enkhbold470/ice-core/media/bottom.png

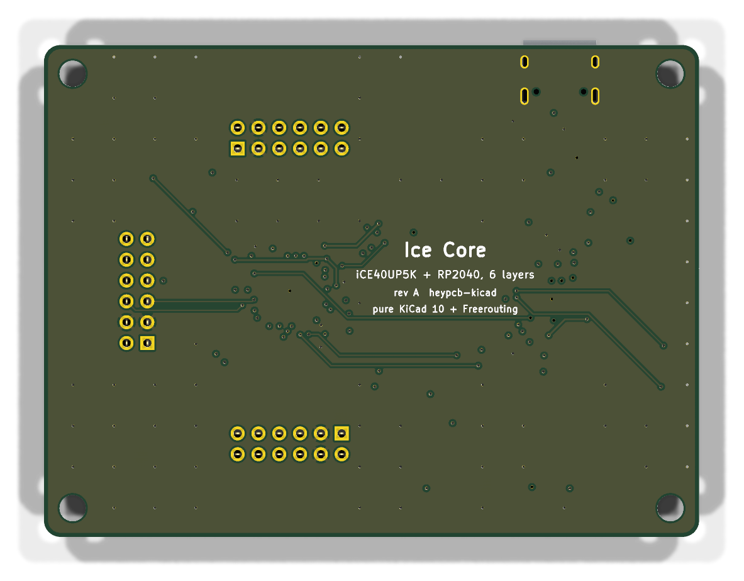
media/bottom.png
