enkhbold470/ice-core/media/top.png

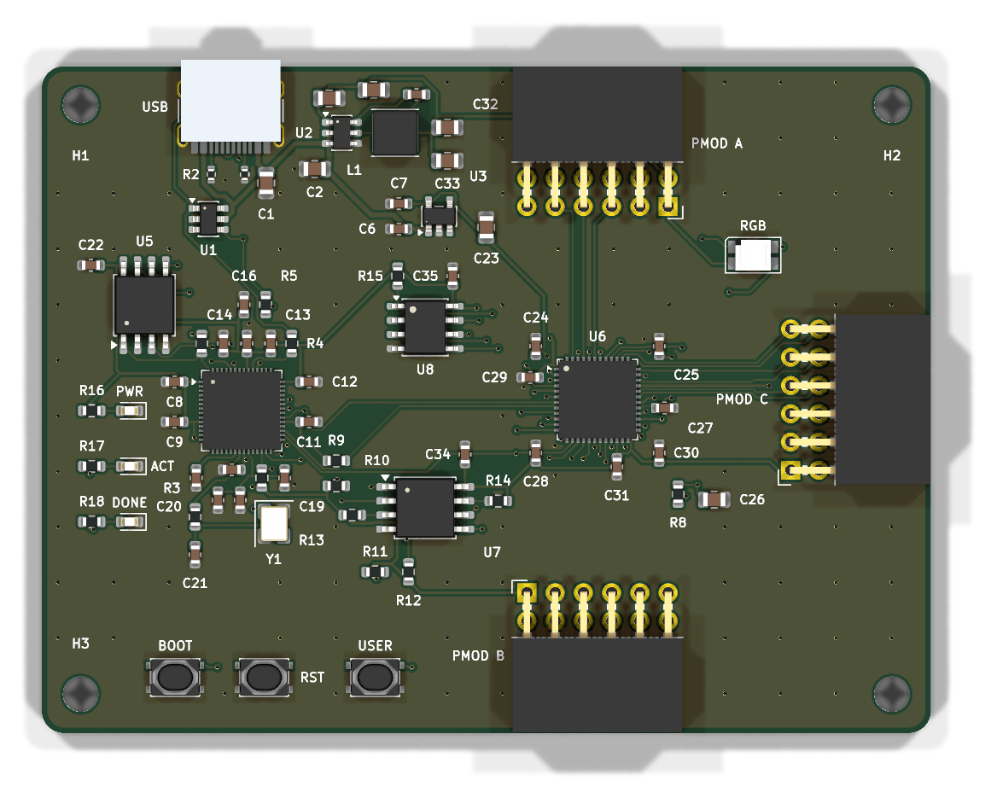
media/top.png
