enkhbold470/ice-core/fab/ice_core_bom.csv

Reference | Value | Footprint | MPN | LCSC | Qty
C1,C2 | 10uF | Capacitor_SMD:C_0805_2012Metric | CL21A106KAYNNNE | C15850 | 2
C3,C4 | 22uF | Capacitor_SMD:C_0805_2012Metric | CL21A226MAQNNNE | C45783 | 2
C5,C8,C9,C10,C11,C12,C13,C14,C15,C18,C19,C22,C24,C25,C27,C28,C29,C30,C31,C34,C35 | 100nF | Capacitor_SMD:C_0603_1608Metric | CC0603KRX7R9BB104 | C14663 | 21
C6,C7,C16,C17 | 1uF | Capacitor_SMD:C_0603_1608Metric | CL10A105KB8NNNC | C15849 | 4
C20,C21 | 15pF | Capacitor_SMD:C_0603_1608Metric | CL10C150JB8NNNC | C1644 | 2
C23,C26,C32,C33 | 4.7uF | Capacitor_SMD:C_0805_2012Metric | CL21A475KAQNNNE | C1779 | 4
D1 | RGB | LED_SMD:LED_Avago_PLCC4_3.2x2.8mm_CW | S4-3528RGBTA-A | C2827321 | 1
D2 | Green (PWR) | LED_SMD:LED_0603_1608Metric | KT-0603G | C12624 | 1
D3 | Red (ACT) | LED_SMD:LED_0603_1608Metric | KT-0603R | C2286 | 1
D4 | Orange (DONE) | LED_SMD:LED_0603_1608Metric | XL-1608UOC-06 | C965800 | 1
J1 | USB-C | Connector_USB:USB_C_Receptacle_HRO_TYPE-C-31-M-12 | TYPE-C-31-M-12 | C165948 | 1
J2 | PMOD_A | Connector_PinSocket_2.54mm:PinSocket_2x06_P2.54mm_Horizontal | PM254-2-06-W-8.5 | C2897426 | 1
J3 | PMOD_B | Connector_PinSocket_2.54mm:PinSocket_2x06_P2.54mm_Horizontal | PM254-2-06-W-8.5 | C2897426 | 1
J4 | PMOD_C | Connector_PinSocket_2.54mm:PinSocket_2x06_P2.54mm_Horizontal | PM254-2-06-W-8.5 | C2897426 | 1
L1 | 3.9uH | Inductor_SMD:L_Sunlord_SWPA4030S | SWPA4030S3R9MT | C96899 | 1
R1,R2 | 5.1k | Resistor_SMD:R_0402_1005Metric | 0402WGF5101TCE | C25905 | 2
R3,R6,R17,R18 | 1k | Resistor_SMD:R_0603_1608Metric | 0603WAF1001T5E | C21190 | 4
R4,R5 | 27 | Resistor_SMD:R_0603_1608Metric | 0603WAF270JT5E | C25190 | 2
R7,R9,R10,R11,R12,R13,R14,R15 | 10k | Resistor_SMD:R_0603_1608Metric | FRC0603F1002TS | C2906982 | 8
R8 | 100 | Resistor_SMD:R_0603_1608Metric | 0603WAF1000T5E | C22775 | 1
R16 | 2.2k | Resistor_SMD:R_0603_1608Metric | 0603WAF2201T5E | C4190 | 1
SW1 | BOOT | Button_Switch_SMD:SW_SPST_PTS810 | PTS810SJM250SMTRLFS | C116501 | 1
SW2 | RESET | Button_Switch_SMD:SW_SPST_PTS810 | PTS810SJM250SMTRLFS | C116501 | 1
SW3 | USER | Button_Switch_SMD:SW_SPST_PTS810 | PTS810SJM250SMTRLFS | C116501 | 1
U1 | USBLC6-2SC6 | Package_TO_SOT_SMD:SOT-23-6 | USBLC6-2SC6 | C7519 | 1
U2 | AP63203WU | Package_TO_SOT_SMD:TSOT-23-6 | AP63203WU-7 | C780769 | 1
U3 | AP2112K-1.2 | Package_TO_SOT_SMD:SOT-23-5 | AP2112K-1.2TRG1 | C460310 | 1
U4 | RP2040 | Package_DFN_QFN:QFN-56-1EP_7x7mm_P0.4mm_EP3.2x3.2mm | RP2040 | C2040 | 1
U5,U7 | W25Q32JVSSIQ | Package_SO:SOIC-8_5.3x5.3mm_P1.27mm | W25Q32JVSSIQ | C179173 | 2
U6 | iCE40UP5K-SG48 | Package_DFN_QFN:QFN-48-1EP_7x7mm_P0.5mm_EP5.6x5.6mm | ICE40UP5K-SG48I | C2678152 | 1
U8 | APS6404L-3SQR-SN | Package_SO:SOIC-8_3.9x4.9mm_P1.27mm | APS6404L-3SQR-SN | C5333729 | 1
Y1 | 12MHz | Crystal:Crystal_SMD_3225-4Pin_3.2x2.5mm | ABM8-272-T3 | C20625731 | 1
