enkhbold470/ice-core/fab/ice_core.step

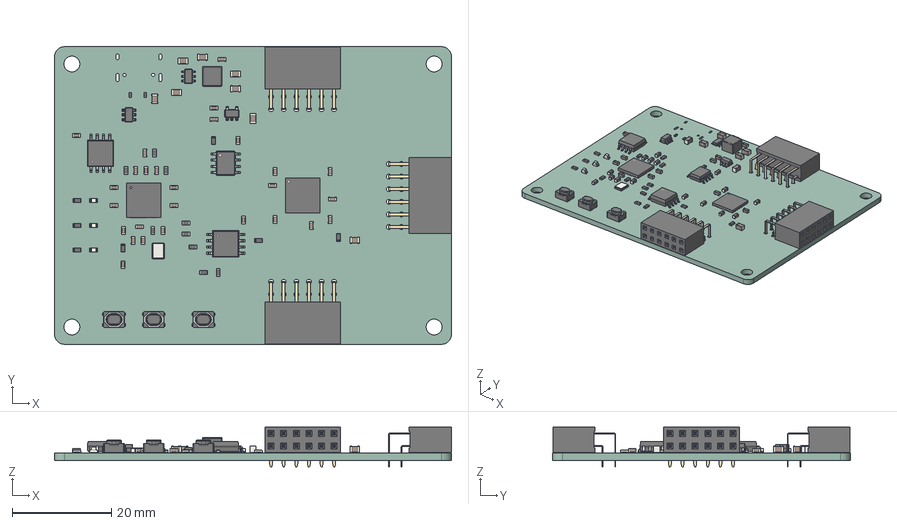
[picture p5: CAD file, 2026-10-02]
fab/ice_core.step
80.0 x 60.0 x 7.98 mm
C_0603_1608Metric x 27
Crystal_SMD_3225-4Pin_3.2x2.5mm
R_0603_1608Metric x 16
TSOT-23-6
SOT-23-5
LED_0603_1608Metric x 3
PinSocket_2x06_P2.54mm_Horizontal x 3
R_0402_1005Metric x 2
SW_SPST_PTS810 x 3
C_0805_2012Metric x 8
SOIC-8_5.3x5.3mm_P1.27mm x 2
QFN-56-1EP_7x7mm_P0.4mm_EP3.2x3.2mm
QFN-48-1EP_7x7mm_Pitch0.5mm
SOT-23-6
a68460a4-8551-11ed-a139-00155d22e2d7_part
a684622a-8551-11ed-a139-00155d22e2d7_part
a68462b6-8551-11ed-a139-00155d22e2d7_part
SOIC-8_3.9x4.9mm_P1.27mm
ice_core_PCB
