enkhbold470/ice-core/fab/ice_core_schematic.pdf

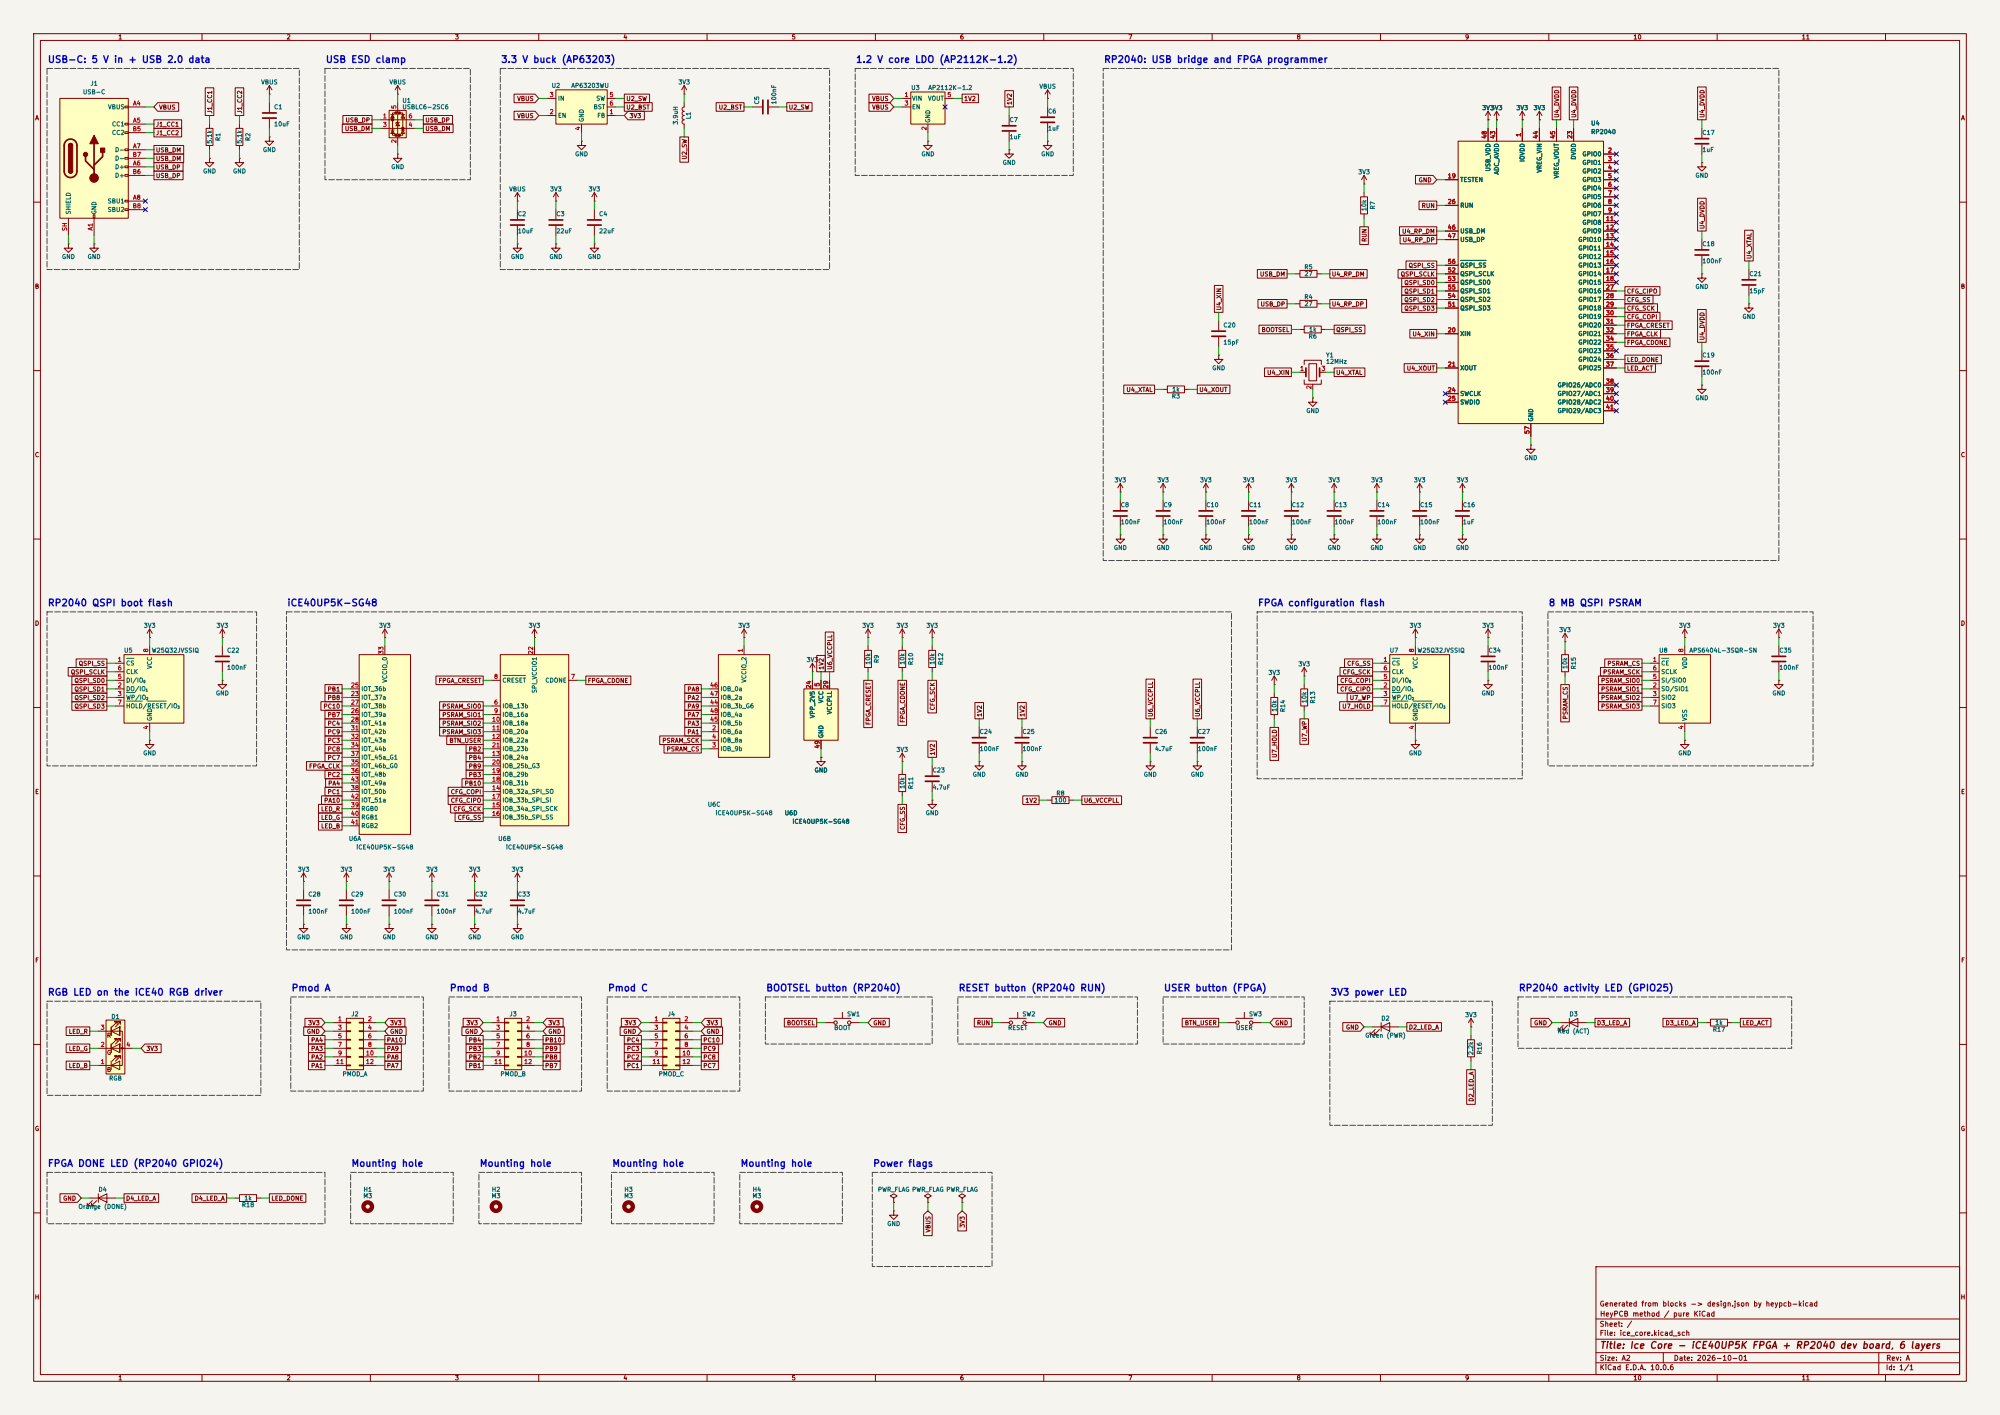
[picture p6: page 1]

USB-C: 5 V in + USB 2.0 data

RP2040: USB bridge and FPGA programmer

4 DI/IO0 5 CLK 6 HOLD/RESET/IO3 7 VCC U5 8W25Q32JVSSIQ

Generated from blocks -> design.json by heypcb-kicad
HeyPCB method / pure KiCad
Sheet: /
File: ice_core.kicad_sch
Title: Ice Core - iCE40UP5K FPGA + RP2040 dev board, 6 layers

Size: A2 | Rev: A
KiCad E.D.A. 10.0.6 | Id: 1/1
