enkhbold470/ice-core/kicad/ice_core.kicad_pcb

## KiCad design kicad/ice_core.kicad_pcb (2026-10-02)

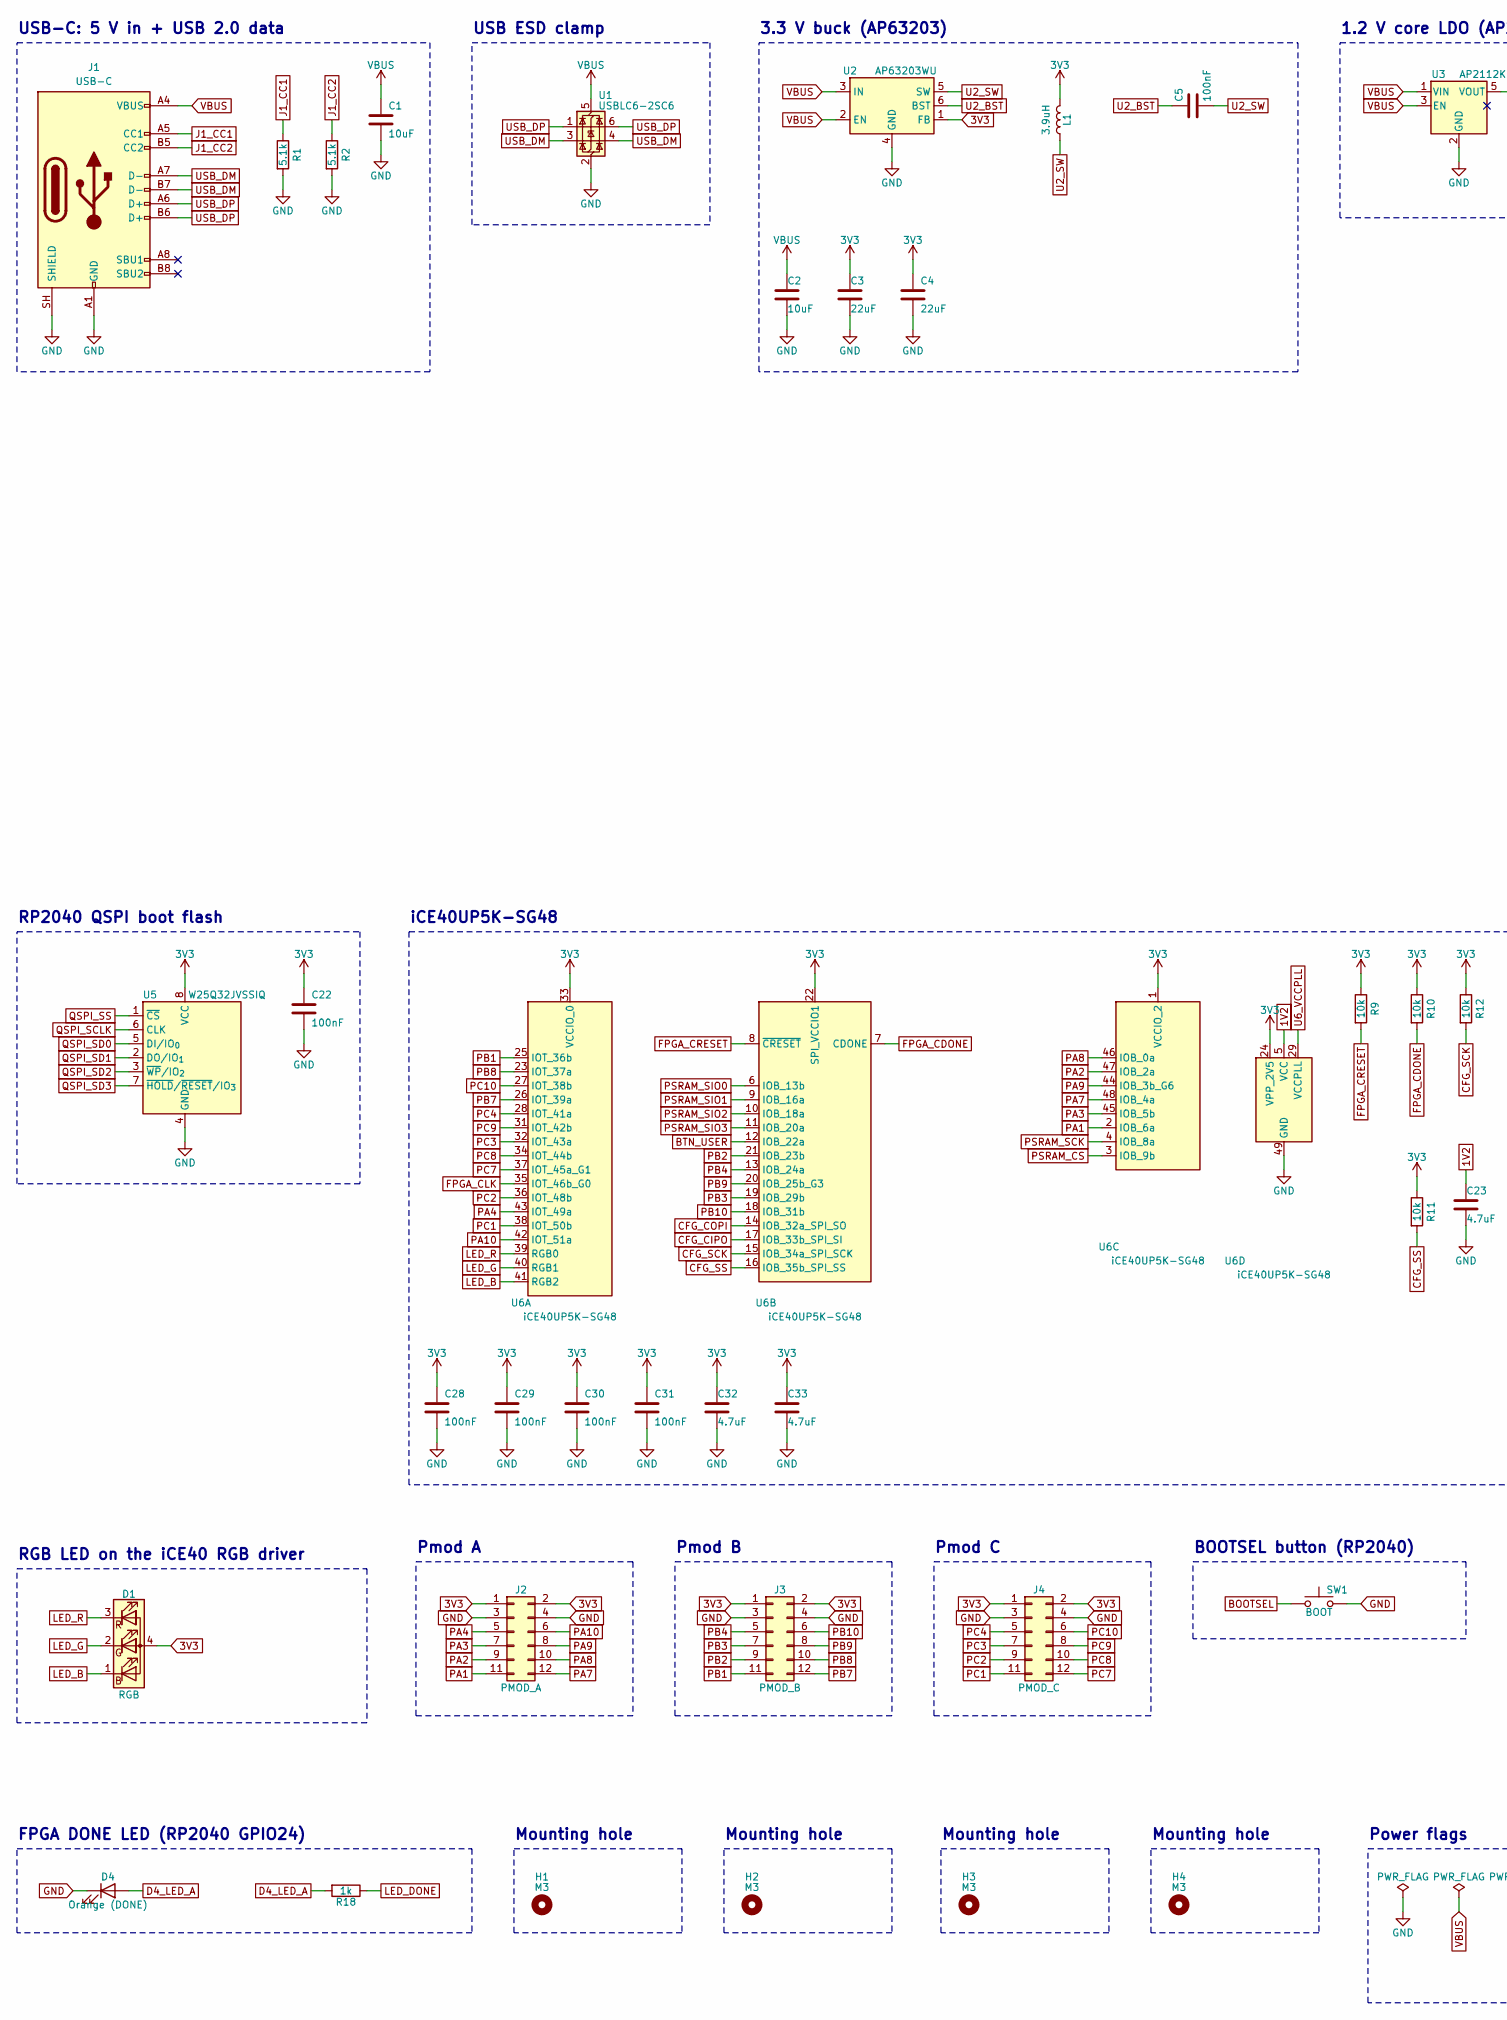
[picture p7: schematic ice_core.kicad_sch, Ice Core - iCE40UP5K FPGA + RP2040 dev board, 6 layers, part in row 1, column 1]

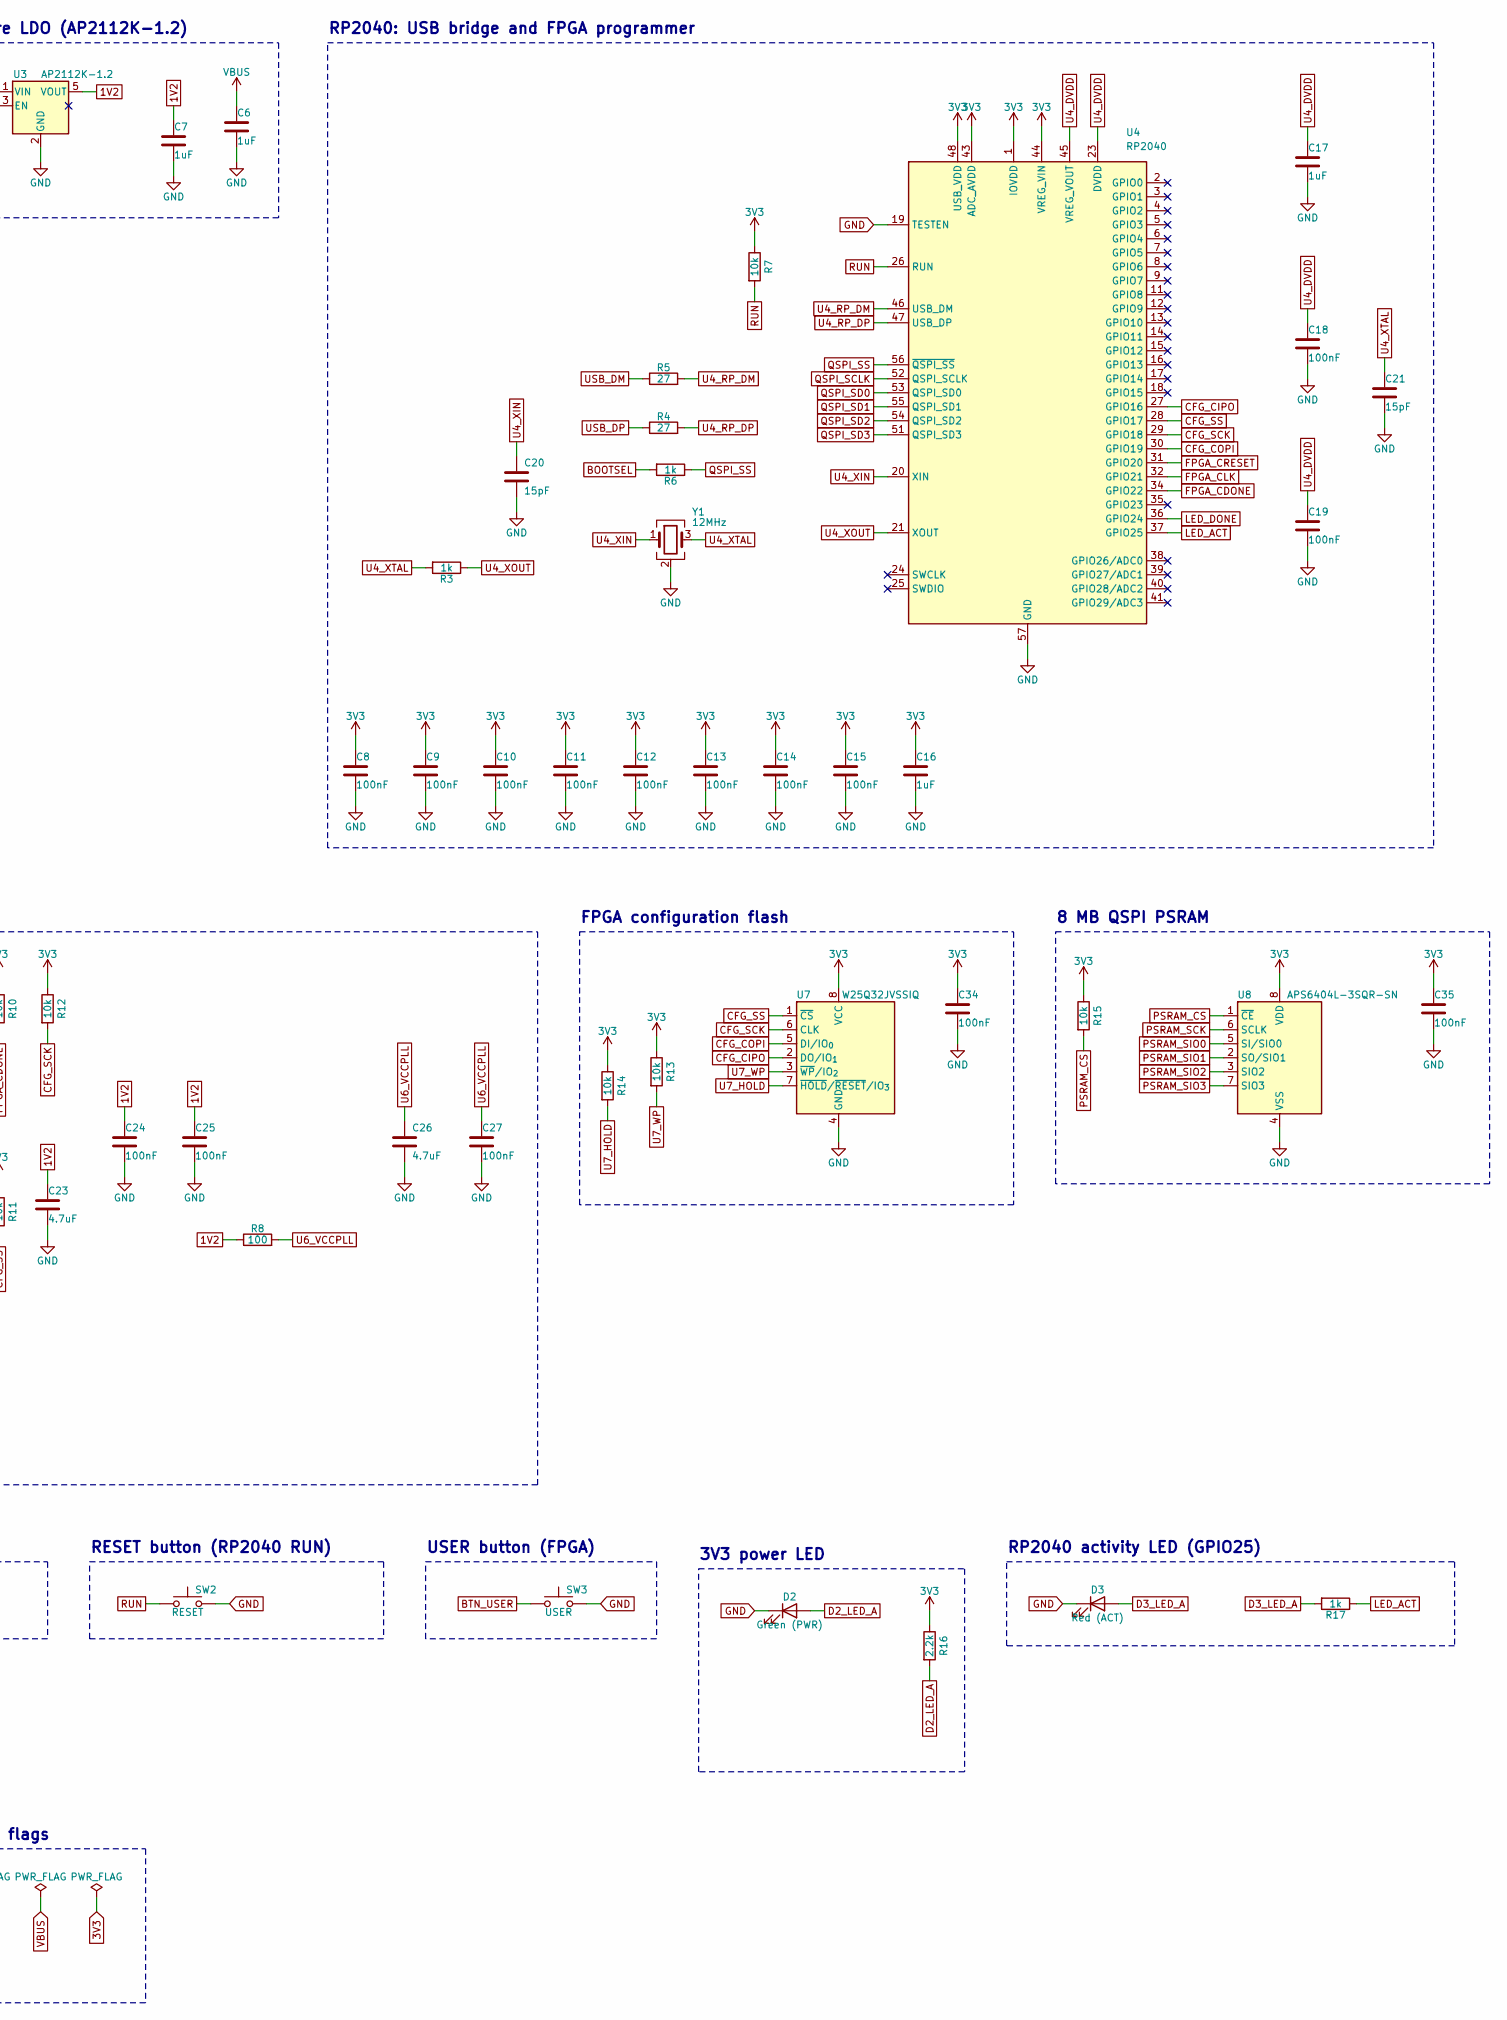
[picture p8: schematic ice_core.kicad_sch, Ice Core - iCE40UP5K FPGA + RP2040 dev board, 6 layers, part in row 1, column 2]

Parts:
C1, C2: 10uF; C_0805_2012Metric; MPN CL21A106KAYNNNE; LCSC C15850
C3, C4: 22uF; C_0805_2012Metric; MPN CL21A226MAQNNNE; LCSC C45783
C5, C8, C9, C10, C11, C12, C13, C14, C15, C18, C19, C22, C24, C25, C27, C28, C29, C30, C31, C34, C35: 100nF; C_0603_1608Metric; MPN CC0603KRX7R9BB104; LCSC C14663
C6, C7, C16, C17: 1uF; C_0603_1608Metric; MPN CL10A105KB8NNNC; LCSC C15849
C20, C21: 15pF; C_0603_1608Metric; MPN CL10C150JB8NNNC; LCSC C1644
C23, C26, C32, C33: 4.7uF; C_0805_2012Metric; MPN CL21A475KAQNNNE; LCSC C1779
D1: RGB; LED_Avago_PLCC4_3.2x2.8mm_CW; MPN S4-3528RGBTA-A; LCSC C2827321
D2: Green (PWR); LED_0603_1608Metric; MPN KT-0603G; LCSC C12624
D3: Red (ACT); LED_0603_1608Metric; MPN KT-0603R; LCSC C2286
D4: Orange (DONE); LED_0603_1608Metric; MPN XL-1608UOC-06; LCSC C965800
H1, H2, H3, H4: M3; MountingHole_3.2mm_M3
J1: USB-C; USB_C_Receptacle_HRO_TYPE-C-31-M-12; MPN TYPE-C-31-M-12; LCSC C165948
J2: PMOD_A; PinSocket_2x06_P2.54mm_Horizontal; MPN PM254-2-06-W-8.5; LCSC C2897426
J3: PMOD_B; PinSocket_2x06_P2.54mm_Horizontal; MPN PM254-2-06-W-8.5; LCSC C2897426
J4: PMOD_C; PinSocket_2x06_P2.54mm_Horizontal; MPN PM254-2-06-W-8.5; LCSC C2897426
L1: 3.9uH; L_Sunlord_SWPA4030S; MPN SWPA4030S3R9MT; LCSC C96899
R1, R2: 5.1k; R_0402_1005Metric; MPN 0402WGF5101TCE; LCSC C25905
R3, R6, R17, R18: 1k; R_0603_1608Metric; MPN 0603WAF1001T5E; LCSC C21190
R4, R5: 27; R_0603_1608Metric; MPN 0603WAF270JT5E; LCSC C25190
R7, R9, R10, R11, R12, R13, R14, R15: 10k; R_0603_1608Metric; MPN FRC0603F1002TS; LCSC C2906982
R8: 100; R_0603_1608Metric; MPN 0603WAF1000T5E; LCSC C22775
R16: 2.2k; R_0603_1608Metric; MPN 0603WAF2201T5E; LCSC C4190
SW1: BOOT; SW_SPST_PTS810; MPN PTS810SJM250SMTRLFS; LCSC C116501
SW2: RESET; SW_SPST_PTS810; MPN PTS810SJM250SMTRLFS; LCSC C116501
SW3: USER; SW_SPST_PTS810; MPN PTS810SJM250SMTRLFS; LCSC C116501
U1: USBLC6-2SC6; SOT-23-6; MPN USBLC6-2SC6; LCSC C7519
U2: AP63203WU; TSOT-23-6; MPN AP63203WU-7; LCSC C780769
U3: AP2112K-1.2; SOT-23-5; MPN AP2112K-1.2TRG1; LCSC C460310
U4: RP2040; QFN-56-1EP_7x7mm_P0.4mm_EP3.2x3.2mm; MPN RP2040; LCSC C2040
U5, U7: W25Q32JVSSIQ; SOIC-8_5.3x5.3mm_P1.27mm; MPN W25Q32JVSSIQ; LCSC C179173
U6: iCE40UP5K-SG48; QFN-48-1EP_7x7mm_P0.5mm_EP5.6x5.6mm; MPN ICE40UP5K-SG48I; LCSC C2678152
U8: APS6404L-3SQR-SN; SOIC-8_3.9x4.9mm_P1.27mm; MPN APS6404L-3SQR-SN; LCSC C5333729
Y1: 12MHz; Crystal_SMD_3225-4Pin_3.2x2.5mm; MPN ABM8-272-T3; LCSC C20625731

Connections:
1V2: C7.1, C23.1, C24.1, C25.1, R8.1, U3.5 (VOUT), U6.5 (VCC), U6.30 (VCC)
3V3: C3.1, C4.1, C8.1, C9.1, C10.1, C11.1, C12.1, C13.1, C14.1, C15.1, C16.1, C22.1, C28.1, C29.1, C30.1, C31.1, C32.1, C33.1, C34.1, C35.1, D1.4 (A), J2.1, J2.2, J3.1, J3.2, J4.1, J4.2, L1.2, R7.1, R9.1, R10.1, R11.1, R12.1, R13.1, R14.1, R15.1, R16.1, U2.1 (FB), U4.1 (IOVDD), U4.10 (IOVDD), U4.22 (IOVDD), U4.33 (IOVDD), U4.42 (IOVDD), U4.43 (ADC_AVDD), U4.44 (VREG_VIN), U4.48 (USB_VDD), U4.49 (IOVDD), U5.8 (VCC), U6.1 (VCCIO_2), U6.22 (SPI_VCCIO1), U6.24 (VPP_2V5), U6.33 (VCCIO_0), U7.8 (VCC), U8.8 (VDD)
BOOTSEL: R6.2, SW1.1
BTN_USER: SW3.1, U6.12 (IOB_22a)
CFG_CIPO: U4.27 (GPIO16), U6.17 (IOB_33b_SPI_SI), U7.2 (DO/IO_{1})
CFG_COPI: U4.30 (GPIO19), U6.14 (IOB_32a_SPI_SO), U7.5 (DI/IO_{0})
CFG_SCK: R12.2, U4.29 (GPIO18), U6.15 (IOB_34a_SPI_SCK), U7.6 (CLK)
CFG_SS: R11.2, U4.28 (GPIO17), U6.16 (IOB_35b_SPI_SS), U7.1 (~CS)
D2_LED_A: D2.2 (A), R16.2
D3_LED_A: D3.2 (A), R17.2
D4_LED_A: D4.2 (A), R18.2
FPGA_CDONE: R10.2, U4.34 (GPIO22), U6.7 (CDONE)
FPGA_CLK: U4.32 (GPIO21), U6.35 (IOT_46b_G0)
FPGA_CRESET: R9.2, U4.31 (GPIO20), U6.8 (~CRESET)
GND: C1.2, C2.2, C3.2, C4.2, C6.2, C7.2, C8.2, C9.2, C10.2, C11.2, C12.2, C13.2, C14.2, C15.2, C16.2, C17.2, C18.2, C19.2, C20.2, C21.2, C22.2, C23.2, C24.2, C25.2, C26.2, C27.2, C28.2, C29.2, C30.2, C31.2, C32.2, C33.2, C34.2, C35.2, D2.1 (K), D3.1 (K), D4.1 (K), J1.A1 (GND), J1.A12 (GND), J1.B1 (GND), J1.B12 (GND), J1.SH (SHIELD), J2.3, J2.4, J3.3, J3.4, J4.3, J4.4, R1.2, R2.2, SW1.2, SW2.2, SW3.2, U1.2 (GND), U2.4 (GND), U3.2 (GND), U4.19 (TESTEN), U4.57 (GND), U5.4 (GND), U6.49 (GND), U7.4 (GND), U8.4 (VSS), Y1.2 (G), Y1.4 (G)
J1_CC1: J1.A5 (CC1), R1.1
J1_CC2: J1.B5 (CC2), R2.1
LED_ACT: R17.1, U4.37 (GPIO25)
LED_B: D1.1 (BK), U6.41 (RGB2)
LED_DONE: R18.1, U4.36 (GPIO24)
LED_G: D1.2 (GK), U6.40 (RGB1)
LED_R: D1.3 (RK), U6.39 (RGB0)
PA1: J2.11, U6.2 (IOB_6a)
PA2: J2.9, U6.47 (IOB_2a)
PA3: J2.7, U6.45 (IOB_5b)
PA4: J2.5, U6.43 (IOT_49a)
PA7: J2.12, U6.48 (IOB_4a)
PA8: J2.10, U6.46 (IOB_0a)
PA9: J2.8, U6.44 (IOB_3b_G6)
PA10: J2.6, U6.42 (IOT_51a)
PB1: J3.11, U6.25 (IOT_36b)
PB2: J3.9, U6.21 (IOB_23b)
PB3: J3.7, U6.19 (IOB_29b)
PB4: J3.5, U6.13 (IOB_24a)
PB7: J3.12, U6.26 (IOT_39a)
PB8: J3.10, U6.23 (IOT_37a)
PB9: J3.8, U6.20 (IOB_25b_G3)
PB10: J3.6, U6.18 (IOB_31b)
PC1: J4.11, U6.38 (IOT_50b)
PC2: J4.9, U6.36 (IOT_48b)
PC3: J4.7, U6.32 (IOT_43a)
PC4: J4.5, U6.28 (IOT_41a)
PC7: J4.12, U6.37 (IOT_45a_G1)
PC8: J4.10, U6.34 (IOT_44b)
PC9: J4.8, U6.31 (IOT_42b)
PC10: J4.6, U6.27 (IOT_38b)
PSRAM_CS: R15.2, U6.3 (IOB_9b), U8.1 (~CE)
PSRAM_SCK: U6.4 (IOB_8a), U8.6 (SCLK)
PSRAM_SIO0: U6.6 (IOB_13b), U8.5 (SI/SIO0)
PSRAM_SIO1: U6.9 (IOB_16a), U8.2 (SO/SIO1)
PSRAM_SIO2: U6.10 (IOB_18a), U8.3 (SIO2)
PSRAM_SIO3: U6.11 (IOB_20a), U8.7 (SIO3)
QSPI_SCLK: U4.52 (QSPI_SCLK), U5.6 (CLK)
QSPI_SD0: U4.53 (QSPI_SD0), U5.5 (DI/IO_{0})
QSPI_SD1: U4.55 (QSPI_SD1), U5.2 (DO/IO_{1})
QSPI_SD2: U4.54 (QSPI_SD2), U5.3 (~WP/IO_{2})
QSPI_SD3: U4.51 (QSPI_SD3), U5.7 (~HOLD/~RESET/IO_{3})
QSPI_SS: R6.1, U4.56 (~QSPI_SS), U5.1 (~CS)
RUN: R7.2, SW2.1, U4.26 (RUN)
U2_BST: C5.1, U2.6 (BST)
U2_SW: C5.2, L1.1, U2.5 (SW)
U4_DVDD: C17.1, C18.1, C19.1, U4.23 (DVDD), U4.45 (VREG_VOUT), U4.50 (DVDD)
U4_RP_DM: R5.2, U4.46 (USB_DM)
U4_RP_DP: R4.2, U4.47 (USB_DP)
U4_XIN: C20.1, U4.20 (XIN), Y1.1
U4_XOUT: R3.1, U4.21 (XOUT)
U4_XTAL: C21.1, R3.2, Y1.3
U6_VCCPLL: C26.1, C27.1, R8.2, U6.29 (VCCPLL)
U7_HOLD: R14.2, U7.7 (~HOLD/~RESET/IO_{3})
U7_WP: R13.2, U7.3 (~WP/IO_{2})
USB_DM: J1.A7 (D-), J1.B7 (D-), R5.1, U1.3 (I/O2), U1.4 (I/O2)
USB_DP: J1.A6 (D+), J1.B6 (D+), R4.1, U1.1 (I/O1), U1.6 (I/O1)
VBUS: C1.1, C2.1, C6.1, J1.A4 (VBUS), J1.A9 (VBUS), J1.B4 (VBUS), J1.B9 (VBUS), U1.5 (VBUS), U2.2 (EN), U2.3 (IN), U3.1 (VIN), U3.3 (EN)

Notes on the sheet:
USB-C: 5 V in + USB 2.0 data
USB ESD clamp
3.3 V buck (AP63203)
1.2 V core LDO (AP2112K-1.2)
RP2040: USB bridge and FPGA programmer
RP2040 QSPI boot flash
iCE40UP5K-SG48
FPGA configuration flash
8 MB QSPI PSRAM
RGB LED on the iCE40 RGB driver
Pmod A
Pmod B
Pmod C
BOOTSEL button (RP2040)
RESET button (RP2040 RUN)
USER button (FPGA)
3V3 power LED
RP2040 activity LED (GPIO25)
FPGA DONE LED (RP2040 GPIO24)
Mounting hole
Power flags

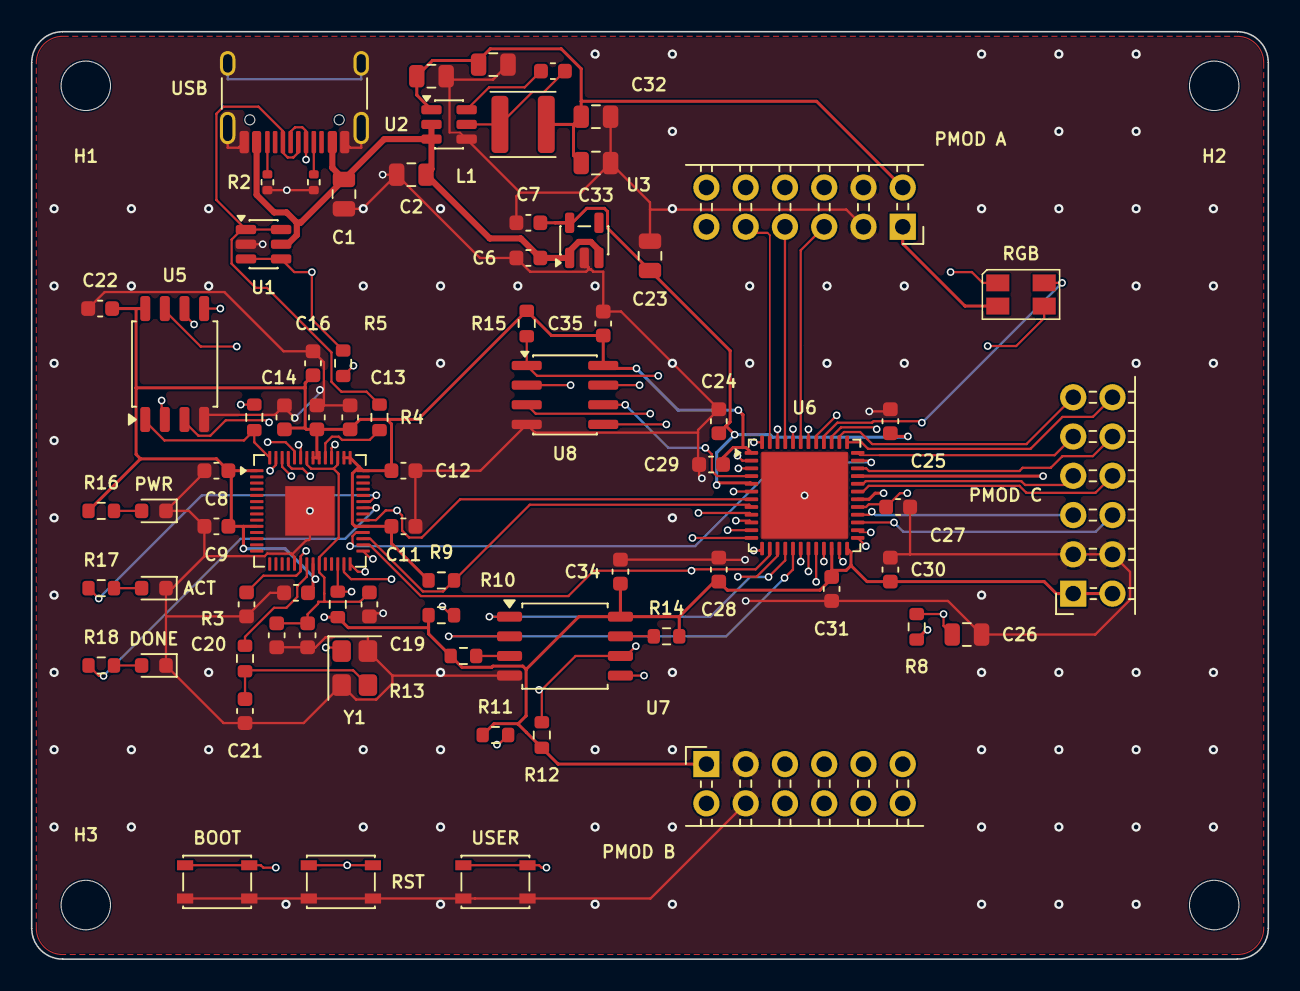
[picture p9: board ice_core.kicad_pcb from above]

Board: 6 copper layers, 80.0 x 60.0 mm, 78 parts (0 on the bottom side), 73 nets.
